Czx666666888888/C-PI/presentations/cpi_defense_20261115/images/mechanism_8.jpg

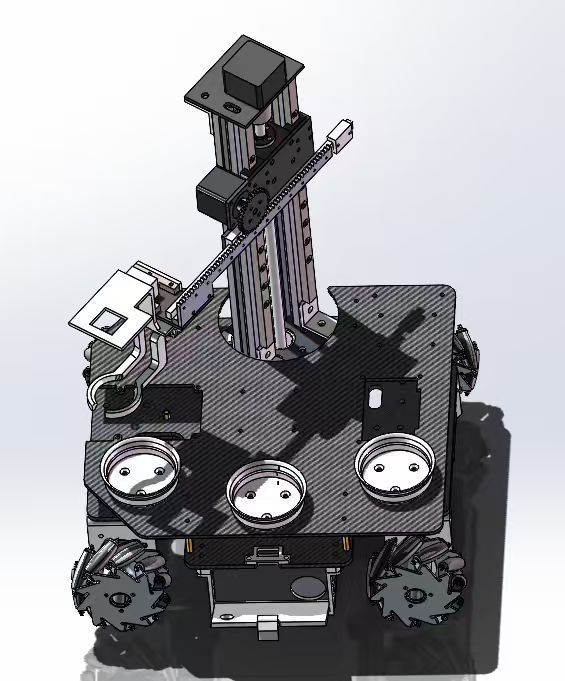
presentations/cpi_defense_20261115/images/mechanism_8.jpg
