Czx666666888888/C-PI/presentations/cpi_defense_20261115/README.md

# 工创赛智能物流运输机器人答辩

[打开10页PPTX](exports/工创赛智能物流运输_答辩10页.pptx) · [交付与验证说明](DELIVERY.md) · [逐页讲稿](notes/total.md)

使用PPT-MASTER制作，16:9、中文，文字和结构图可编辑，含原生预算表格和逐页备注。内容覆盖设计思路、结构与功能原理、自制件结构图、电控、OPS与视觉、预算、进度、预期效果与实车演示。

第5页为未标注尺寸的结构示意，需要原始工程图才能作为加工依据。第8页预算和计划为建议估算；第10页待替换GIF，目前为实车静态图。详见交付说明。

svg_output/为完整页面设计源，images/为团队素材，notes/为讲稿。参考原件、缓存、日志和本地检查输出不进入Git。未改动底盘代码或已有固件修改。
