Czx666666888888/C-PI/presentations/cpi_defense_20261115/design_decisions.md

# Design decisions

用户在聊天明确确认“按建议，后续你决定”，授权后续设计决策。采用 free_design，中文，ppt169，现场答辩及会后查阅。

三个完整方向：
1. 工程证据：先展示实车成熟度，再按机构—电控—定位视觉解释设计，最后说明投入与验收。白底深蓝标题、青绿重点、细线与大图，微软雅黑/Arial一致字体。图片保留真实CAD背景，原理用可编辑线图表达；若需插图则采用无材质的结构线描。本次只用用户素材。选择此方案，适合评委核对设计与实物。
2. 技术展演：以整车全幅图起篇，分镜揭示执行机构、感知与控制，最终展示整车动作。深色画布、青色节点，微软雅黑配Consolas数字。若需插图则使用暗底发光的设备轮廓。本次不选，因自制零件图纸与预算更适合浅色页面。
3. 项目论证：结论先行，围绕可靠搬运的约束、方案取舍、成本和交付路径展开。白底蓝灰、宋体标题与微软雅黑正文形成对比；若需插图则用平面等距示意。本次不选，因用户希望机构和进展有充分展示。

最终：18页，balanced阅读密度，正文24px，标题40px，注释18px，页脚14px，封面56px，分组标题30px。模式custom参考instructional的总分顺序；视觉custom参考swiss-minimal的对齐与留白。实物/CAD图片provided。无AI图片、无旁白、无对象动画；启用逐页讲稿。连续生成，brief设计规格，不再审阅设计规格。

事实边界：当前实车和电控完成状态来自用户本次陈述；仓库中USB链路及绝对定位精度尚有UNVERIFIED记录，不将其写成整车自主验收通过。旧PPT预算约1500仅为历史参考；本次预算2200为拟增补估算，非报价或报销。无原始带尺寸工程图，提供结构示意并注明不能代替加工图。无GIF附件，预留演示区域，不伪造动作。无已确认当前OPS PCB图片，采用底部定位机构与电控联调照片。

用户追加要求小于等于10页：最终10页，合并需求与架构、预算与进度、成果与验收，末页保留GIF区域。
