Czx666666888888/C-PI/presentations/cpi_defense_20261115/notes/02_design.md

我们的设计从完整任务闭环出发。机器人需要读取任务、识别物料，完成抓取和车载储存，再自主运输到相应工位，按序放置和码垛，最后返回起点。方案同时考虑初始投影不超过三百乘三百毫米、高度不超过四百毫米、单电源以及完全自主运行等约束，具体尺寸仍要实测核对，并以后续官方规则为准。系统采用分层设计：摄像头与OPS提供感知输入，树莓派负责视觉、任务和路径规划，C板负责实时电机闭环与机构动作。这样可以让复杂计算与实时控制各自承担适合的工作。
