Czx666666888888/C-PI/presentations/cpi_defense_20261115/notes/06_electronics.md

电控以DJI C板的STM32F407为实时控制核心，通过FreeRTOS组织任务，控制CAN底盘、升降伸缩机构和舵机夹爪，同时结合BMI088姿态反馈。树莓派承担视觉与规划，两者通过USB CDC承载既有V1协议交换目标和状态。协议明确长度、序号、单位、CRC校验与心跳。控制上强调只有一个统一目标入口，手动优先，自主控制不能与遥控线程抢写；通信超时或目标失效后停止相关自主运动，错误帧不能更新目标。团队已确认电控完成调试，但仓库中USB实板枚举和双向链路仍有未验证记录，所以模块调试完成与整车自主链路验收需要区分。
