Czx666666888888/C-PI/docs/frustum_top_center_v1.md

# 圆台上表面中心实验 V1

独立分支 `feature/frustum-top-center`，基于 `feature/stm32-uart-v1` 的 `9f967ca`。工具入口为 `PI/vision/experiments/frustum_top_center.py`，所有实验筛选参数在同名JSON；初始数值是待标定的实验假设，不是已验证的通用阈值。未替换生产算法、改参考点、通信或固件。

## 几何与方法

整体颜色连通域包括上表面和侧面。外接矩形中心由轮廓极值决定，侧面改变极值便会偏移；面积质心同样被侧面面积加权。两者只作为对照，不能解释为抓取中心。

复用 `legacy.physical_detect.colors_to_track`（含红色双HSV区间），按原处理顺序执行红通道0.9、5×5高斯、HSV阈值和5×5开运算。实验在干净图像上分割，不复制原程序分割前画参考十字的副作用。最大外轮廓与原500像素面积阈值用于整体ROI和矩形/质心对照，不送入上表面fitEllipse。

- A_gradient：V通道Sobel局部梯度、Canny、ROI内部约束；由内部边缘轮廓以及随机5点生成候选，用全体内部边缘的近似几何距离筛内点，再fitEllipse细化。支持部分边缘，但纹理/阴影也可能形成错误候选。
- B_contour：灰度高斯+Canny，在侵蚀后的ROI中寻找内部轮廓，逐个拟合和细化。覆盖角度筛选约束近闭合程度，断裂严重时预期报INVALID。
- 两方法共用中心在ROI内、顶部位置先验、轴比、相对宽度/面积、最少支持点、角度覆盖率及残差筛选。参数均可调，但不可为追求成功率而逐帧调阈值。当前顶部先验假设上表面位于图像ROI的较上部分；相机翻转/圆台倒放等不符合该先验。
- 实物检查发现A可能拟合侧面短弧。因此A/B只标作候选，最终TopEllipse要求两方法均通过且中心距离不超过配置agreement_px（初始3像素，仍待标注校准），选取残差较低的已有椭圆，不平均成一个未经拟合的中心；否则最终FitValid=False。两方法相关，并非独立测量，一致性也不能保证绝对正确。
- `residual_px` 为隐式椭圆的一阶几何距离近似的内点RMS，不是精确最近点距离；`coverage`为24角度分箱的支持比例。FitValid只表示通过这些数值筛选，仍须人工确认边缘确实是上表面；低残差不保证语义正确。
- 上表面不可见、反光、弱对比、遮挡、ROI过小等均可能失败。侵蚀会排除侧面外边界，也会删去与外轮廓重合的上表面后沿；应通过剩余内部弧的支持判断，不把整个颜色轮廓当圆。

OpenCV接口依据：[fitEllipse/轮廓特征](https://docs.opencv.org/4.13.0/dd/d49/tutorial_py_contour_features.html)。图像椭圆中心仅是二维估计，透视下不等于真实三维圆心投影；未标注时不能报告绝对定位精度。

## 使用与输出

先检查 `systemctl is-active cpi-vision`、`fuser /dev/video0`。服务占用摄像头时按既有流程征得用户确认，再临时停止；退出、检查无实验采集占用后恢复原服务。工具不会自行停止服务，也不打开任何控制串口。

```powershell
python PI/vision/experiments/frustum_top_center.py --help
python PI/vision/experiments/frustum_top_center.py --host cpi --duration 15 --label center --output .local/frustum-center-still
python PI/vision/experiments/frustum_top_center.py --image .local/example.jpg --headless --output .local/frustum-offline
python -m unittest discover -s PI/tests -v
```

沿用OpenSSH配置/免密密钥和严格主机验证。Pi仅采集640×480 MJPG，再以长度前缀JPEG（质量95）传Windows；Windows进行两种实验分析并显示四格画面。队列只保留最新帧，主动跳过的预览帧单独计数，不当作摄像头丢帧；JPEG压缩会影响边缘，后续应比较无损样本。处理时间较长时算法FPS不等于摄像头采集FPS。

画面显示原图、HSV Mask、外轮廓/矩形、矩形中心（黄）、质心（青）、A候选椭圆中心（紫）、B候选椭圆中心（绿）、最终TopEllipse（橙）、两套候选边缘以及白色参考点(290,260)。失败显示INVALID，不回退成矩形中心。Q/Esc/关闭窗口退出；1/2/3/4/5切换中央/左/右/上/下标签。静止指标应单独开15秒会话或排除移动阶段，不能把移动过程算抖动。

终端逐方法报告cx/cy/dx/dy、FitResidual、最终FitValid及CandidateValid。统一 `dx=cx-290`、`dy=260-cy`，不再减参考点。每帧CSV保存两种基线、A/B候选及最终TopEllipse；summary.json按位置和方法统计数值通过率、中心标准差、连续有效相邻帧位移RMS、与矩形中心均值差。INVALID占分母；连续帧位移不会跨越INVALID帧计算。无有效拟合时输出null，而不是0误差。移动标签间的中心均值变化是物体位置变化，不是定位误差。

结果目录另保存配置快照、最近原图及对比图，全部放忽略的`.local/`，不提交照片、CSV或运行日志。不要对未经确认静止的片段宣称抖动指标，不对无真值样本宣称精度。需用人工标注的上表面边界/中心，再比较各位置相对标注的偏差。

## 验证与实测记录

软件：CLI帮助及原6项Pi测试PASS；新增5项合成测试PASS：内部椭圆恢复并与整体中心区分、无内部边缘时拒绝、短弧即使残差为零仍拒绝、非640×480拒绝、候选不一致/单方法候选时最终INVALID。共11项PASS。合成测试证明代码几何与失败处理，不证明实物性能。

首轮探索会话包含用户摆放和移动，不作为中央静止抖动/五位置精度验收。已看到部分实物内部边缘，A间歇接受候选、B经常INVALID；不能据此替换生产程序。

### 2026-11-07真实圆台结果

用户逐位置摆放红色实物并移开手，使用既有Pi USB相机、640×480和Windows SSH预览。各位置约10秒，共808个处理帧；中央和右侧含移动的早期会话弃作静止统计，另开固定会话。表内是固定会话的描述性指标，没有人工中心真值；位置标签是用户摆放名称，实际图像位置以矩形中心均值列为准，右侧只略偏画面中线，尚不是对整个视野边缘的充分覆盖。

| 位置 | 帧数 | 矩形中心均值(cx,cy) | A候选通过率 | B候选通过率 | A中心std(x,y)像素 | A相邻帧位移RMS像素 | A−矩形均值差(x,y)像素 |
|---|---:|---|---:|---:|---|---:|---|
| 中央 | 172 | (268.00,297.40) | 0/172 | 0/172 | INVALID | — | — |
| 左侧 | 158 | (145.20,271.00) | 0/158 | 0/158 | INVALID | — | — |
| 右侧 | 165 | (342.32,278.99) | 164/165 (99.4%) | 0/165 | (2.30,1.22) | 3.75 | (+4.19,−0.63) |
| 上方 | 159 | (214.00,191.00) | 0/159 | 0/159 | INVALID | — | — |
| 下方 | 154 | (235.00,367.00) | 77/154 (50.0%) | 0/154 | (2.81,2.43) | 5.73 | (+1.39,−16.62) |

矩形/质心相邻帧位移RMS分别为：中央0.684/0.350、左侧0.586/1.620、右侧0.663/0.262、上方0/0.220、下方0/0.161像素。量化后的矩形中心零变化不表示零定位误差。质心相对矩形均值差依次为(−1.28,−0.70)、(−0.01,−1.71)、(−0.90,−0.74)、(−3.00,−1.26)、(−2.67,−0.55)像素；它仍受整个侧面面积影响，不能凭抖动小就认为是真中心。

下方A在人工复查图中出现侧面反光/短弧误拟合；上述A/B数值通过率不是上表面识别准确率。五位置B都失败，按最终一致性规则均不应输出TopEllipse。后加的最终规则又实机运行8秒：接收145帧、处理123帧、主动跳过22帧；A候选6/123，B=0/123，最终TopEllipse=0/123，INVALID保护PASS，准确上表面定位目标未达成（FAIL）。未对缺失的椭圆中心计算假偏差或零抖动。

光照对照：保持下方位置，用户确认已改变照明，但未说明开关哪盏灯，无照度测量，也未锁相机曝光。采160帧，A为19/160(11.9%)、B=0；A std=(1.74,1.37)、相邻位移RMS=3.02、A−矩形=(−3.63,+4.17)像素。矩形均值变为(234.01,367.69)，与前段接近。可观察到候选通过率和偏移变化，不能把它严格归因于某个单独光照变量；量化光照鲁棒性仍UNVERIFIED。

边缘不完整：真实遮挡会话185帧中A接受54帧(29.2%)，B为0；画面中手遮挡上表面，不能作为正常中央验收。合成45度短弧测试即使残差为0也被覆盖率拒绝。物理图像的少量内部弧不足以稳定恢复完整圆面；中央最后样本A/B内部边缘仅25/62像素，左侧为0/46像素。离线将覆盖门限从0.55降到0.45、0.35，对中央同一快照仍均INVALID；生产/实机配置未因此放宽。

收尾：各会话正常结束并回收SSH，接收线程退出。远端fuser无实验摄像头占用、无残留python -u -采集后，恢复cpi-vision至active/enabled、SubState=running、MainPID=2671。原unit和serial0配置未变，未发送任何机构控制帧。所有照片、CSV、配置快照与日志仅在.local/保留，不随Git提交。

### 结论与下一阶段

目前不建议替换生产模块。A能在部分视角拟合候选，但更抖且会选错边缘；B在当前小目标/弱内部边缘下缺少覆盖，全部固定位置失败。最终保守输出INVALID是诚实拒绝，不代表已经解决中心定位。

优先顺序：先固定相机姿态/焦距并增大物块成像尺寸、用可控漫射光减少侧面高光，确认原始图中上表面边界可辨；采同一物体五位置与光照下的无损样本并人工标注边界/二维中心；再依据标注验证边缘方向、外轮廓重合的上缘与内部前弧的组合、局部颜色/梯度一致性和鲁棒拟合。当前ROI顶部位置先验未标定，跨画面位置时上表面可能出现在不同方向，需一并验证，不能仅靠图像y较小选择“顶部”。最后才考虑时间滤波；滤波不能修复抓错平面或固定偏差。镜头畸变、透视椭圆中心与三维圆心投影差异仍是独立误差来源；绝对定位精度UNVERIFIED。

提交范围：独立实验脚本/JSON、实验测试和本文档。验证命令为python -m unittest discover -s PI/tests -v（11项PASS）、实验CLI与真实SSH会话、scoped git diff --check、Git差异审阅。原生产识别、UART协议及固件未修改；原本地Keil脏文件保留。
