Czx666666888888/C-PI/docs/roadmap.md

# 开发路线

| 里程碑 | 内容 | 验收 |
| --- | --- | --- |
| M0 | 保存原有 Keil 工程基线 | 编译与现有底盘运行 |
| M1 | 双向 UART 与协议 | 心跳、CRC、状态回传 |
| M2 | 模式仲裁与速度指令 | 自主运动、反馈、失联停车 |
| M3 | 树莓派二维码识别 | 任务码解析成功率 |
| M4 | 视觉位置矫正 | 定位误差实测 |
| M5 | 接入全场定位 | 灰色车道自主移动 |
| M6 | 运输与抓取联调 | 全任务成功率与时间 |

当前优先任务：通信链路与可验证的速度闭环。

## 2026-11-05 最新状态

- 树莓派固定有线地址 `192.168.123.50/24`；PC `192.168.123.99/24`，已在树莓派断开 Wi-Fi 时成功新建有线 SSH，Wi-Fi 随后恢复。重启/拔插后自动恢复尚未实测。
- 原始树莓派 Python 源码已归档；物料检测函数在 Pi 运行，带标记画面已传到 PC 实时显示，640×480、约 15–18 FPS。准确率未验收。
- 全黑图 100 次测试正常返回空结果；没有“未检测就停止”的保护。两次预览中断有 USB 断连记录，原因未确定，长期稳定性未通过。
- 本轮预览已结束、摄像头无占用；没有串口或运动测试。
- 详细证据与命令见 `PI/README.md`。

## 用户计划：2026-11-06

先确认摄像头 USB 稳定性，建立物料/背景样本与识别基线，优化视觉识别算法；同时定稿并编写上位机通信，覆盖 HELLO、HEARTBEAT、SET_VELOCITY、STATUS、帧校验和超时契约。
串口控制台占用、USART3 实物接口、控制权仲裁和断线停车仍是联调前的必办项。
