Czx666666888888/C-PI/presentations/cpi_defense_20261115/notes/01_cover.md

各位老师好，我们的作品是面向工创赛智能物流运输赛道的搬运机器人。本项目已经完成实车搭建，电控部分也已完成调试。目前的主要工作，是全场OPS定位、视觉优化以及两者与任务流程的集成。下面从任务设计、机械结构、电控原理和后续计划介绍我们的方案。
