Czx666666888888/C-PI/presentations/cpi_defense_20261115/notes/03_structure.md

机械上，我们将移动、抓取和存储集成在一台紧凑的整车上。底盘采用四麦克纳姆轮布局，便于前后运动、横移和原地转向，以适应工位停靠和狭窄空间调整。上部由升降立柱和水平伸缩夹爪完成取放，三工位储料盘用于车载存放，避免运输时始终用夹爪夹持物料。底视图展示了驱动与测量的分离，独立的底部测量组件服务于后续OPS位姿估计。底盘继续沿用已调试的驱动方案，定位测量部分则重点开展安装与标定。
