Czx666666888888/C-PI/presentations/cpi_defense_20261115/notes/04_manipulator.md

抓放动作被拆分成升降、伸缩和夹爪开合。丝杆提供竖直运动，导轨约束姿态；齿轮齿条改变水平抓取距离；舵机驱动夹爪开合，完成物料夹持。一次典型抓取依次进行高度对齐、水平接近、夹持、收回和车载储存。动作分解后，各执行机构可以独立调试，再逐步协同。右侧实物图对应丝杆与伸缩连接部位，后续联调还会复核运动行程、限位以及机构干涉。
