Czx666666888888/C-PI/presentations/cpi_defense_20261115/notes/07_ops_vision.md

当前工作重点是让全场定位与工位视觉形成互补。OPS路线是结合轮组位移和姿态得到全场位姿，再服务路线跟踪。需要逐项完成接地状态、尺度、方向符号与坐标对齐标定，并通过直线、横移、转向和闭合路线记录误差。视觉侧采用OpenCV处理二维码、颜色和物料中心，输出颜色、中心偏差和有效性。现有接口以二百九十、二百六十为参考点，偏差不再重复计算。当前还在优化圆台上表面中心稳定性，优先固定相机姿态、减少反光并采集多位置光照样本。现有实验尚未达到准确上表面定位目标，绝对定位精度仍待验证。计划由全场定位接近工位，再在确认目标有效后进行局部矫正与抓放。
