Czx666666888888/C-PI/presentations/cpi_defense_20261115/notes/08_budget_schedule.md

后续经费优先复用现有实车、控制器和执行机构，拟增补两千二百元。其中OPS器件与标定八百元，视觉与光照三百元，结构迭代与加工三百元，电气备件三百元，场地耗材三百元，机动预留两百元。这是建议估算，尚未核价，也不等于整车已发生总成本。进度建议分四个阶段：第一周开展OPS安装与标定，第二周积累视觉样本并收敛单工位抓放，第三周融合路线与任务动作，第四周开展整场统计、稳定性验证及答辩整理。阶段开始日期依团队实际确定，并按照验收结果推进下一步。
