Czx666666888888/C-PI/presentations/cpi_defense_20261115/notes/09_progress_expected.md

这些照片展示了我们的实车结构、电控调试现场以及升降伸缩机构细节。当前已有整车搭建和电控调试基础，下一步集中推进定位、视觉及完整流程。预期效果是自主完成两批物料搬运，按序放置码垛并返回起点。我们将用重复试验和完整视频记录停靠误差、抓放成功率、整场耗时及异常停车表现。当前这些量化指标仍待实测，预期目标不代表已经通过整场验收。
