Czx666666888888/C-PI/presentations/cpi_defense_20261115/notes/10_demo.md

最后留出实车进展演示。这里可以替换为底盘移动、升降抓放和视觉识别的GIF片段；当前材料中没有GIF，所以暂用实车静态照片展示。我们已经有实车和模块调试基础，后续将持续把单模块稳定性转化为整场自主运行能力。感谢各位老师，欢迎批评指正。
