Czx666666888888/C-PI/presentations/cpi_defense_20261115/notes/total.md

# 01_cover

各位老师好，我们的作品是面向工创赛智能物流运输赛道的搬运机器人。本项目已经完成实车搭建，电控部分也已完成调试。目前的主要工作，是全场OPS定位、视觉优化以及两者与任务流程的集成。下面从任务设计、机械结构、电控原理和后续计划介绍我们的方案。

---

# 02_design

我们的设计从完整任务闭环出发。机器人需要读取任务、识别物料，完成抓取和车载储存，再自主运输到相应工位，按序放置和码垛，最后返回起点。方案同时考虑初始投影不超过三百乘三百毫米、高度不超过四百毫米、单电源以及完全自主运行等约束，具体尺寸仍要实测核对，并以后续官方规则为准。系统采用分层设计：摄像头与OPS提供感知输入，树莓派负责视觉、任务和路径规划，C板负责实时电机闭环与机构动作。这样可以让复杂计算与实时控制各自承担适合的工作。

---

# 03_structure

机械上，我们将移动、抓取和存储集成在一台紧凑的整车上。底盘采用四麦克纳姆轮布局，便于前后运动、横移和原地转向，以适应工位停靠和狭窄空间调整。上部由升降立柱和水平伸缩夹爪完成取放，三工位储料盘用于车载存放，避免运输时始终用夹爪夹持物料。底视图展示了驱动与测量的分离，独立的底部测量组件服务于后续OPS位姿估计。底盘继续沿用已调试的驱动方案，定位测量部分则重点开展安装与标定。

---

# 04_manipulator

抓放动作被拆分成升降、伸缩和夹爪开合。丝杆提供竖直运动，导轨约束姿态；齿轮齿条改变水平抓取距离；舵机驱动夹爪开合，完成物料夹持。一次典型抓取依次进行高度对齐、水平接近、夹持、收回和车载储存。动作分解后，各执行机构可以独立调试，再逐步协同。右侧实物图对应丝杆与伸缩连接部位，后续联调还会复核运动行程、限位以及机构干涉。

---

# 05_custom_parts

主要自制件围绕安装和具体作业需求设计。主承载板统一底盘、立柱和其他模块的装配接口，并考虑安装孔、中央避让和装配基准。电机连接支架则承担驱动部件的固定，正视图强调轴孔与固定孔，侧视图说明直角连接关系。夹爪和横移连接板需要适配圆形物料及运动空间，定位轮支撑组件则关注独立安装、稳定接地与标定重复性。这里的承载板和支架是用于答辩说明的结构示意，下面配有团队CAD视图。由于本次没有带尺寸的原始工程图，孔位、外形、公差和材料仍以团队最终CAD为准，本页不能用于加工下单。

---

# 06_electronics

电控以DJI C板的STM32F407为实时控制核心，通过FreeRTOS组织任务，控制CAN底盘、升降伸缩机构和舵机夹爪，同时结合BMI088姿态反馈。树莓派承担视觉与规划，两者通过USB CDC承载既有V1协议交换目标和状态。协议明确长度、序号、单位、CRC校验与心跳。控制上强调只有一个统一目标入口，手动优先，自主控制不能与遥控线程抢写；通信超时或目标失效后停止相关自主运动，错误帧不能更新目标。团队已确认电控完成调试，但仓库中USB实板枚举和双向链路仍有未验证记录，所以模块调试完成与整车自主链路验收需要区分。

---

# 07_ops_vision

当前工作重点是让全场定位与工位视觉形成互补。OPS路线是结合轮组位移和姿态得到全场位姿，再服务路线跟踪。需要逐项完成接地状态、尺度、方向符号与坐标对齐标定，并通过直线、横移、转向和闭合路线记录误差。视觉侧采用OpenCV处理二维码、颜色和物料中心，输出颜色、中心偏差和有效性。现有接口以二百九十、二百六十为参考点，偏差不再重复计算。当前还在优化圆台上表面中心稳定性，优先固定相机姿态、减少反光并采集多位置光照样本。现有实验尚未达到准确上表面定位目标，绝对定位精度仍待验证。计划由全场定位接近工位，再在确认目标有效后进行局部矫正与抓放。

---

# 08_budget_schedule

后续经费优先复用现有实车、控制器和执行机构，拟增补两千二百元。其中OPS器件与标定八百元，视觉与光照三百元，结构迭代与加工三百元，电气备件三百元，场地耗材三百元，机动预留两百元。这是建议估算，尚未核价，也不等于整车已发生总成本。进度建议分四个阶段：第一周开展OPS安装与标定，第二周积累视觉样本并收敛单工位抓放，第三周融合路线与任务动作，第四周开展整场统计、稳定性验证及答辩整理。阶段开始日期依团队实际确定，并按照验收结果推进下一步。

---

# 09_progress_expected

这些照片展示了我们的实车结构、电控调试现场以及升降伸缩机构细节。当前已有整车搭建和电控调试基础，下一步集中推进定位、视觉及完整流程。预期效果是自主完成两批物料搬运，按序放置码垛并返回起点。我们将用重复试验和完整视频记录停靠误差、抓放成功率、整场耗时及异常停车表现。当前这些量化指标仍待实测，预期目标不代表已经通过整场验收。

---

# 10_demo

最后留出实车进展演示。这里可以替换为底盘移动、升降抓放和视觉识别的GIF片段；当前材料中没有GIF，所以暂用实车静态照片展示。我们已经有实车和模块调试基础，后续将持续把单模块稳定性转化为整场自主运行能力。感谢各位老师，欢迎批评指正。
