Czx666666888888/C-PI/firmware/Core/Src/main.c

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
/* Includes ------------------------------------------------------------------*/
#include "main.h"
#include "cmsis_os.h"
#include "adc.h"
#include "can.h"
#include "dma.h"
#include "i2c.h"
#include "spi.h"
#include "tim.h"
#include "usart.h"
#include "gpio.h"

/* USER CODE BEGIN Includes */
#include "chassis_can.h"
#include "chassis.h"
#include "X_V2.h"
#include "bsp_can.h"
#include "6020_pid.h"
#include "OLED.h"
#include "bsp_adc.h"
#include "ist8310driver.h"
#include "BMI088driver.h"
#include "SG90.h"
#include "usb_cpi.h"
/* USER CODE END Includes */

/* USER CODE BEGIN PD */
#define CHASSIS_LOOP_DT_S      0.002f
#define CHASSIS_FORWARD_SPEED  0.25f
/* USER CODE END PD */


void SystemClock_Config(void);
void MX_FREERTOS_Init(void);
/* USER CODE BEGIN 0 */
fp32  ist8310_mag[3];              /* IST8310 磁力计三轴数据 (μT), DefaultTask 中更新 */
volatile uint8_t ist8310_data_ready = 0;  /* DRDY 中断标志, ISR 置位 / 任务清0 */
uint8_t ist8310_init_status;        /* ist8310_init() 返回值, 0=正常 */
uint8_t bmi088_init_status;         /* BMI088_init() 返回值, 0=正常 */

/**
  * @brief  GPIO 外部中断回调 (IST8310 DRDY / KEY)
  * @param  GPIO_Pin: 触发中断的引脚号
  * @retval 无
  */
void HAL_GPIO_EXTI_Callback(uint16_t GPIO_Pin)
{
    /* KEY 按键：无操作，按键仅在 main() 启动门控中使用 */
    if (GPIO_Pin == IST8310_DRDY_Pin)
    {
        ist8310_data_ready = 1;  /* 仅置标志，I2C 读取在任务上下文中完成 */
    }
}
/* USER CODE END 0 */

/**
  * @brief  The application entry point.
  * @retval int
  */
int main(void)
{

  /* MCU Configuration--------------------------------------------------------*/

  /* Reset of all peripherals, Initializes the Flash interface and the Systick. */
  HAL_Init();

  /* Configure the system clock */
  SystemClock_Config();

  /* Initialize all configured peripherals */
  MX_GPIO_Init();
  MX_DMA_Init();
  MX_ADC1_Init();
  MX_ADC3_Init();
  MX_TIM1_Init();
  MX_TIM4_Init();
  MX_TIM8_Init();
  MX_USART1_UART_Init();
  MX_USART3_UART_Init();
  MX_USART6_UART_Init();
  MX_I2C2_Init();
  MX_I2C3_Init();
  MX_SPI1_Init();
  MX_CAN1_Init();
  MX_CAN2_Init();
  /* USER CODE BEGIN 2 */
  USB_CPI_Init(); /* 先枚举，仍保留原KEY门控；未启动任务前不会执行颜色动作。 */
  /* ═══════════════════════════════════════════════════════════════════
   * 按键启动门控（对齐 6.key_exit）
   * 上电后在此等待 PA0 按下 → PB14 拉高 → 延时 300ms → 启动全部流程
   * ═══════════════════════════════════════════════════════════════════ */
  {
    GPIO_InitTypeDef key_gpio = {0};

    /* PB14 初始化为推挽输出低电平 */
    key_gpio.Pin   = GPIO_PIN_14;
    key_gpio.Mode  = GPIO_MODE_OUTPUT_PP;
    key_gpio.Pull  = GPIO_NOPULL;
    key_gpio.Speed = GPIO_SPEED_FREQ_LOW;
    HAL_GPIO_Init(GPIOB, &key_gpio);
    HAL_GPIO_WritePin(GPIOB, GPIO_PIN_14, GPIO_PIN_RESET);

    /* LED3(PH10) 闪烁表示等待按键 */
    HAL_GPIO_WritePin(LED3_GPIO_Port, LED3_Pin, GPIO_PIN_SET);

    /* 等待按键按下（PA0 上拉，按下为低电平）*/
    while (HAL_GPIO_ReadPin(KEY_GPIO_Port, KEY_Pin) != GPIO_PIN_RESET);
    HAL_Delay(20);   /* 消抖 */
    while (HAL_GPIO_ReadPin(KEY_GPIO_Port, KEY_Pin) != GPIO_PIN_RESET);

    HAL_GPIO_WritePin(LED3_GPIO_Port, LED3_Pin, GPIO_PIN_RESET);

    /* 拉高 PB14，延时 300ms 后启动全部流程 */
    HAL_GPIO_WritePin(GPIOB, GPIO_PIN_14, GPIO_PIN_SET);
    HAL_Delay(300);
  }

  /* --- CAN filters: bank 0 (GM6020) + bank 1 (chassis/lift) --- */
  can_filter_init();                                        /* GM6020 yaw motor: filter bank 0 → FIFO0 */
  chassis_can_filter_init();                                /* Chassis/lift motors: filter bank 1 → FIFO1 */
  /* CAN Start / ActivateNotification 已移至 Chassis_Task 开头（FreeRTOS 启动后执行）*/
  gimbal_PID_init();                                        /* GM6020 云台 PID 初始化 */
  SG90_Init();                                              /* SG90 夹爪舵机初始化 (TIM1_CH1, PE9, 50Hz) */
  OLED_Init();                                              /* 2.42吋 OLED 初始化 (PF1/PF0 软件 I2C) */
  init_vrefint_reciprocal();                                /* ADC 内部基准电压校准 */
  ist8310_init_status = ist8310_init();                     /* IST8310 磁力计初始化 (I2C3, DRDY PG3), 保存返回值 */
  bmi088_init_status = BMI088_init();                       /* BMI088 陀螺仪+加速度计初始化 (SPI1, CS=PA4/PB0), 保存返回值 */
  /* USER CODE END 2 */

  /* Call init function for freertos objects (in cmsis_os2.c) */
  MX_FREERTOS_Init();

  /* Start scheduler */
  osKernelStart();

  /* We should never get here as control is now taken by the scheduler */

  /* Infinite loop */
  /* USER CODE BEGIN WHILE */
  while (1)
  {
    /* USER CODE END WHILE */

    /* USER CODE BEGIN 3 */
  }
  /* USER CODE END 3 */
}

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
/**
  * @brief  Period elapsed callback in non blocking mode
  * @note   This function is called  when TIM2 interrupt took place, inside
  * HAL_TIM_IRQHandler(). It makes a direct call to HAL_IncTick() to increment
  * a global variable "uwTick" used as application time base.
  * @param  htim : TIM handle
  * @retval None
  */
void HAL_TIM_PeriodElapsedCallback(TIM_HandleTypeDef *htim)
{
  if (htim->Instance == TIM2)
  {
    HAL_IncTick();
  }
}

/**
  * @brief  This function is executed in case of error occurrence.
  * @retval None
  */
void Error_Handler(void)
{
  /* USER CODE BEGIN Error_Handler_Debug */
  /* User can add his own implementation to report the HAL error return state */
  __disable_irq();
  while (1)
  {
  }
  /* USER CODE END Error_Handler_Debug */
}
#ifdef USE_FULL_ASSERT
/**
  * @brief  Reports the name of the source file and the source line number
  *         where the assert_param error has occurred.
  * @param  file: pointer to the source file name
  * @param  line: assert_param error line source number
  * @retval None
  */
void assert_failed(uint8_t *file, uint32_t line)
{
  /* USER CODE BEGIN 6 */
  /* User can add his own implementation to report the file name and line number,
     ex: printf("Wrong parameters value: file %s on line %d\r\n", file, line) */
  /* USER CODE END 6 */
}
#endif /* USE_FULL_ASSERT */
