Czx666666888888/C-PI/firmware/DJI C board.ioc

Mcu.UserName=STM32F407IGHx
PA0-WKUP.GPIO_Label=KEY
PA0-WKUP.Signal=GPXTI0
PA10.Signal=S_TIM1_CH3
PA11.Signal=USB_OTG_FS_DM
PA12.Signal=USB_OTG_FS_DP
PA13.Signal=SYS_JTMS-SWDIO
PA14.Signal=SYS_JTCK-SWCLK
PA9.Signal=S_TIM1_CH2
PE9.Signal=S_TIM1_CH1
PB12.Signal=CAN2_RX
PB13.Signal=CAN2_TX
PB3.Signal=SPI1_SCK
PB4.Signal=SPI1_MISO
PB5.Signal=SPI1_MOSI
PB6.Signal=USART1_TX
PB7.Signal=USART1_RX
PB8.Signal=S_TIM4_CH3
PB9.Signal=CAN1_TX
PC10.Signal=USART3_TX
PC11.Signal=USART3_RX
PC9.Signal=I2C3_SDA
PD0.Signal=CAN1_RX
PF0.Signal=I2C2_SDA
PF1.Signal=I2C2_SCL
PF10.Signal=ADC3_IN8
PG14.Signal=USART6_TX
PG3.GPIO_Label=IST8310_DRDY
PG3.Signal=GPXTI3
PG6.GPIO_Label=IST8310_RST
PG6.Signal=GPIO_Output
PG9.Signal=USART6_RX
PH0-OSC_IN.Signal=RCC_OSC_IN
PH1-OSC_OUT.Signal=RCC_OSC_OUT
PH10.GPIO_Label=LED3
PH10.Signal=GPIO_Output
PH11.GPIO_Label=LED2
PH11.Signal=GPIO_Output
PH12.GPIO_Label=LED1
PH12.Signal=GPIO_Output
PA8.Signal=I2C3_SCL
PI5.Signal=S_TIM8_CH1
PI6.Signal=S_TIM8_CH2
PI7.Signal=S_TIM8_CH3
