Czx666666888888/C-PI/firmware/Core/Inc/main.h

#define IST8310_RST_Pin GPIO_PIN_6
#define IST8310_RST_GPIO_Port GPIOG
#define LED1_Pin GPIO_PIN_12
#define LED1_GPIO_Port GPIOH
#define IST8310_DRDY_Pin GPIO_PIN_3
#define IST8310_DRDY_GPIO_Port GPIOG
#define LED2_Pin GPIO_PIN_11
#define LED2_GPIO_Port GPIOH
#define LED3_Pin GPIO_PIN_10
#define LED3_GPIO_Port GPIOH
#define KEY_Pin GPIO_PIN_0
#define KEY_GPIO_Port GPIOA
#define KEY_EXTI_IRQn EXTI0_IRQn
#define BMI088_ACCEL_CS_Pin       GPIO_PIN_4
#define BMI088_ACCEL_CS_GPIO_Port GPIOA
#define BMI088_GYRO_CS_Pin        GPIO_PIN_0
#define BMI088_GYRO_CS_GPIO_Port  GPIOB
