Czx666666888888/C-PI/(commit log)

2026-11-05 feat: import original DJI C board firmware
2026-11-05 chore: archive Raspberry Pi source and record wired SSH validation
    Files: README.md, docs/pi_network.md, raspberry_pi/README.md, and 10 original Python files plus SHA256SUMS under raspberry_pi/legacy.
    Validation: ast.parse on legacy/*.py: 10/10 PASS without execution; sha256sum -c SHA256SUMS: 10/10 PASS, matching remote hashes; git diff --check on edited documentation: PASS. Wired SSH bound to 192.168.123.99 reached 192.168.123.50; nmcli and ip confirmed static eth0, autoconnect, no wired default route, and retained Wi-Fi.
    Remaining: cameras unplugged per user; camera recognition, serial protocol/CRC/timeout stopping, firmware build and hardware integration UNVERIFIED. ttyS0 console/getty oc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
2026-11-05 feat: preview Pi material detection on PC over wired SSH
    Files: raspberry_pi/preview_material.py, README.md and .gitignore. Calls the original Pi detector with 640x480 MJPG and returns annotated JPEG frames over SSH; no serial access. Q/Esc stops preview.
    Validation: python3 -m py_compile raspberry_pi/preview_material.py PASS; headless --frames 90 --snapshot /tmp/cpi_material_preflight.jpg PASS with 90 decoded, zero skipped and no camera read failures; preview cleanup confirmed with fuser. GUI window confirmed by xwininfo and continuing logs around 18 FPS. git diff --check PASS.
    Remaining: classification accuracy and all material colors UNVERIFIED pending user observation. Camera device path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
    [preview_material.py]
2026-11-05 docs: record camera USB interruption during live preview
    Updated raspberry_pi/README.md with actual 1063-frame, 62.7-second run and subsequent failure. Read-only dmesg check confirmed USB disconnect and re-enumeration with error -71. Long-duration stability remains UNVERIFIED; preview restarted after device reappeared.
2026-11-05 docs: record repeated USB disconnect and power flag check
2026-11-05 docs: update material detection status and next-session tasks
    Files: raspberry_pi/README.md and docs/roadmap.md. Records camera/PC preview results, 100 successful empty black-frame results, unresolved USB interruptions, released camera and next-day vision/host-communication plan.
    Validation: git diff --check PASS. Read-only SSH pgrep/fuser confirmed no preview worker or camera owner; vcgencmd get_throttled returned 0x0 and dmesg tail showed no USB events after 23:15:34 at inspection. No new vision or motion run.
    Remaining: vision accuracy, USB long-run stability, communication framing/CRC/timeout stopping and hardware integration UNVERIFIED.
2026-11-06 feat(pi): integrate vision UART V1 and headless systemd service
    Files: Pi runtime, protocol, detector adapter, config, deployment/service scripts, tests and UART docs; firmware unchanged.
    Validation: python3 -m unittest discover -s raspberry_pi/tests -p test_protocol.py -v (4 PASS); Pi venv unittest discover -s tests -v (6 PASS); Pi scripts/mock_uart_test.py (PTY rates, ACK/STATUS, reconnect PASS); manual camera and combined UART run PASS.
    Pending: real RGB material acceptance, physical USB unplug recovery, DJI C board protocol and motion timeout verification. Host PTY run lacked pyserial; successful PTY run used existing Pi venv.
2026-11-06 docs(pi): record deployed UART and systemd validation evidence
    Files: deployment validation report and Pi README. Verification: Pi PTY 9.796/1.999 Hz, missing-device resilience, real camera, systemctl stop/start/restart, reboot SSH/autostart, SIGKILL automatic restart and deployment SHA256 matches PASS. Real RGB materials, physical USB recovery, C board and motion watchdog remain UNVERIFIED.
2026-11-07 chore(windows): restore Pi history and validate Keil workspace
    Preserve local firmware original; migrate raspberry_pi to PI; add conflict-aware OpenSSH sync and portable PowerShell entry points. Keil ARMCC 5.06u7 rebuild passed with 0 errors and 14 existing warnings; 6 Pi and 4 sync tests passed. SSH deployment and ST-Link hardware remain UNVERIFIED; details in docs/windows_migration.md.
    [main.py, preview_material.py]
2026-11-07 feat(pi): validate Windows SSH camera preview workflow
    Reuse OpenSSH identities and add timed preview statistics. Real hardware: 90 frames and 75-second/1579-frame GUI preview passed; RGB blocks observed and Q cleanup/service restoration checked. Record intermittent USB disconnects and user-reported center bias without changing the detector or firmware. Six existing tests and syntax checks passed.
2026-11-07 feat(stm32): add V1 UART feedback and CRSF auto grip arbitration
    Reuse USART3 DMA and existing MAIN/TOWER tasks. Preserve CRSF and manual mappings; accept fresh V1 targets, ACK and STATUS, close SG90 once for red in AUTO. Keil rebuilt with 0 errors/14 existing warnings; 6 actual-C host tests and 6 Pi tests pass. Hardware and flashing remain UNVERIFIED; retain pre-existing local Keil config changes outside this commit.
    [harness.c, pi_link.c, pi_link.h, test_pi_link.py, usart.c]
2026-11-07 docs(stm32): record clean Keil build and hardware test boundaries
2026-11-07 docs(stm32): distinguish migration baseline from implemented V1
2026-11-07 feat(stm32): add green release and timed blue forward action
    Reuse TOWER for red close/green open and UART_RX for blue 0.25m/s forward up to 1s, without blocking manual takeover. Stop early on invalid/stale/changed target and wait for chassis init. Seven actual-C host tests and real Keil build pass (0 errors, 14 existing warnings). No flashing or hardware movement tests; preserve pre-existing local Keil config changes.
    [harness.c, test_pi_link.py]
2026-11-07 feat(stm32): carry V1 protocol over MicroUSB CDC
    Use matching CubeF4 HAL1.8.5 PCD and ST USB Device CDC without upgrading existing drivers. Configure PA11/PA12 and PLLQ7 for 48MHz USB, retain CPU168MHz and SG90 PWM. Reuse V1 parser/colors, static async TX buffer and ISR RX ring; do not start USART3 input in MAIN. Real Keil build 0 errors/14 existing warnings, 10 firmware and 6 Pi host tests pass. USB hardware enumeration and flashing UNVERIFIED; preserve existing local project options.
    [DJI C board.ioc, harness.c, main.c, pi_link.c, test_usb.py]
2026-11-07 docs(usb): record post-flash enumeration blocker and camera preview
2026-11-07 docs: record USB diagnosis and next data-cable test
    Update README.md and docs/usb_cdc.md with SWD observations, Windows/Pi enumeration failure, user-reported power-only cable, restored camera service and next-session steps. Validation: scoped git diff --check PASS, diff review, Get-PnpDevice and SSH systemctl checks. No production code changes; real USB protocol and color actions remain UNVERIFIED.
2026-11-07 feat(vision): add isolated frustum top-center experiment
    Add experiment Python/JSON, synthetic tests, README link and docs/frustum_top_center_v1.md; preserve production vision, protocol and firmware. Compare boundingRect/moments with V-gradient RANSAC and internal-contour ellipse candidates, explicit INVALID and conservative final agreement. Validation: unittest discover -s PI/tests -v (11 PASS), CLI help, scoped diff --check PASS; real SSH 640x480 five-position 808-frame study plus lighting/occlusion and final rejection check, original camera service restored. Top-center reliability FAIL: weak/incomplete rims and side-reflection false candidates; absolute accuracy UNVERIFIED. Raw frames/log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
2026-11-14 docs(presentation): add 10-slide intelligent logistics defense deck
    Add editable mechanical and control diagrams, OPS/vision progress, estimated budget, staged plan, speaker notes and GIF display area. SVG final gate: 10 pages, 0 errors, 0 warnings. PPTX postflight passed; ZIP/XML checks confirm 10 slides, 10 notes and one native table. Remaining: actual GIF, dimensioned CAD, budget confirmation and hardware performance verification. Existing firmware edits excluded.
